kagerorijal/assistive-color-detector/docs/device_photo2.jpeg

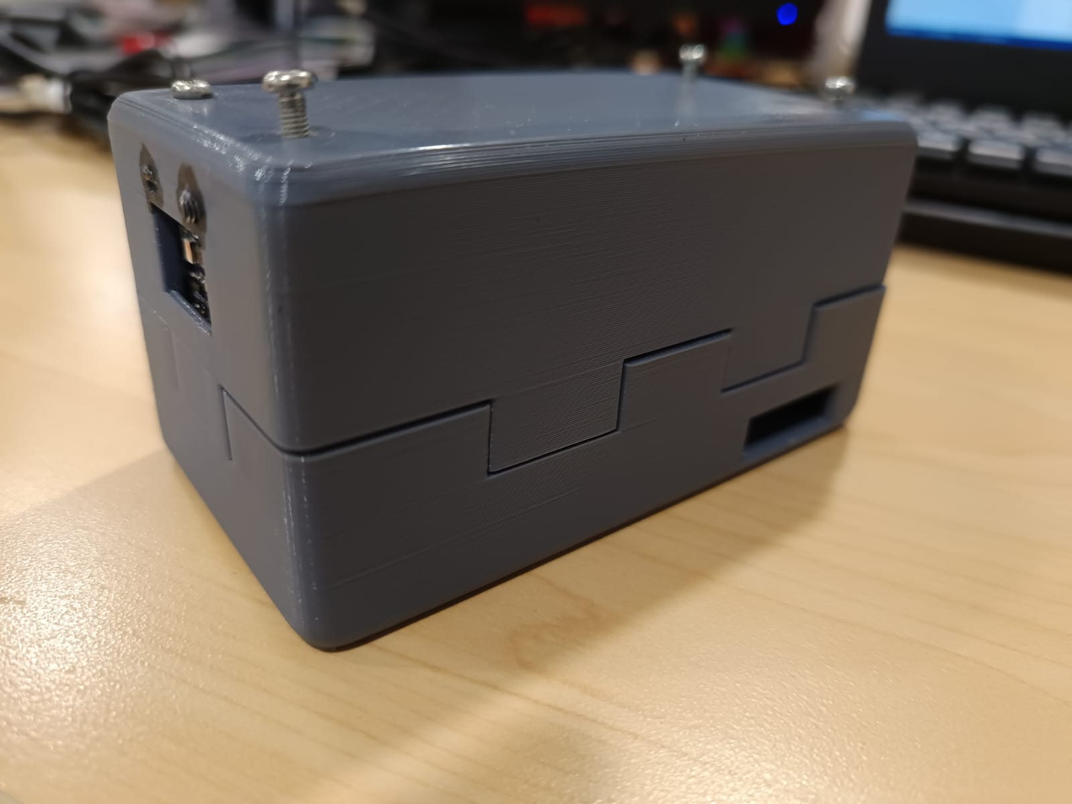
docs/device_photo2.jpeg
