kagerorijal/assistive-color-detector/docs/device_photo1.jpeg

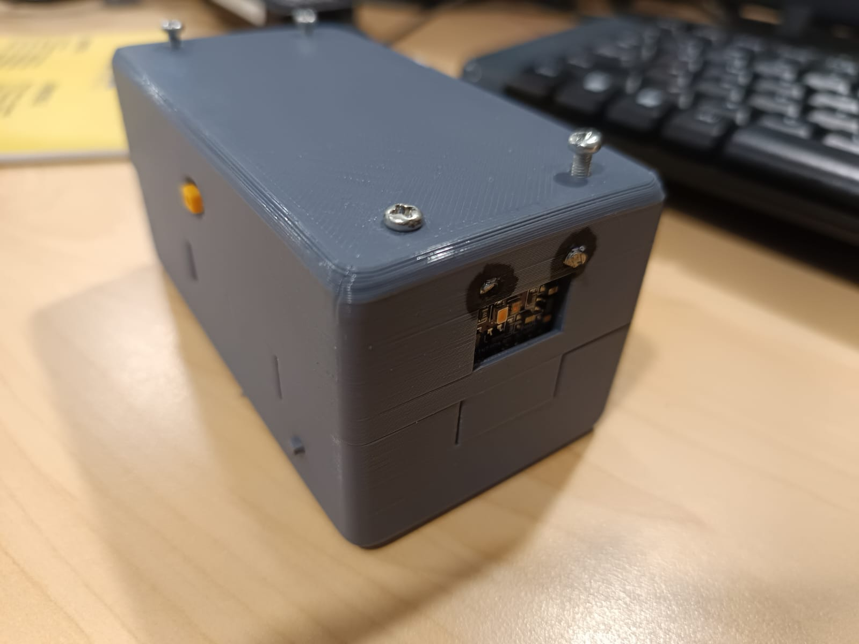
docs/device_photo1.jpeg
